revaldinho/cpc-cplink/doc/CPCCPLINKFront.jpg

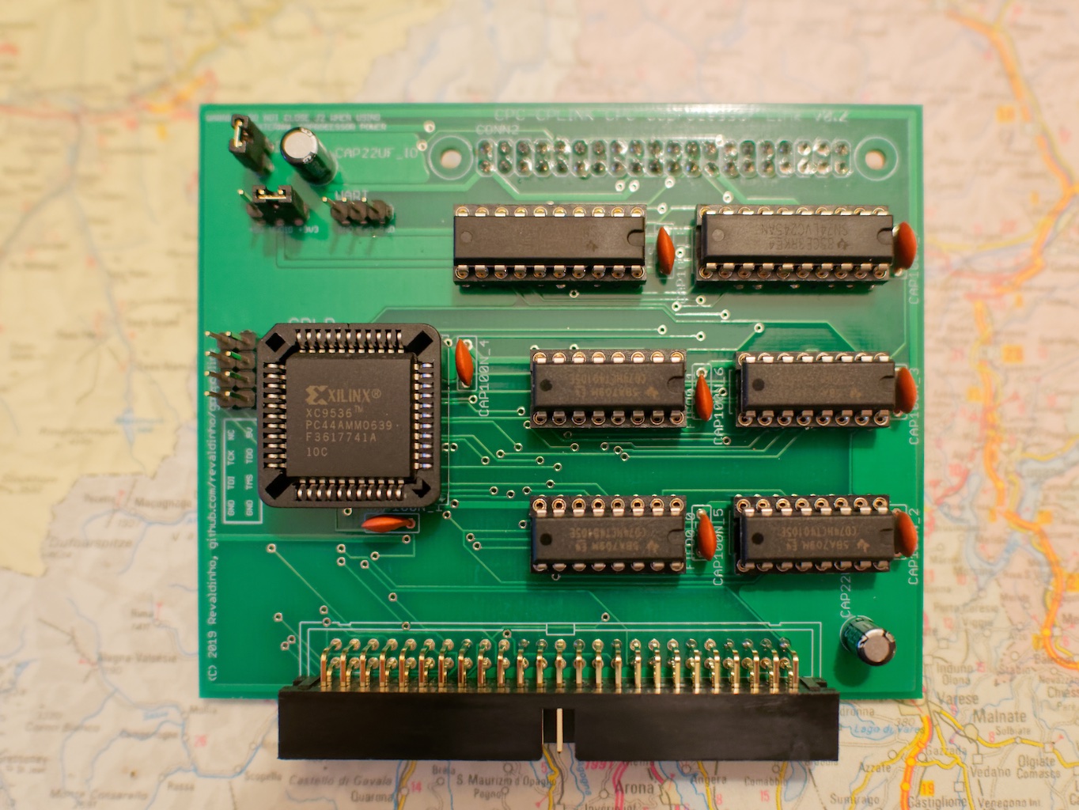
doc/CPCCPLINKFront.jpg
