revaldinho/cpc-cplink/doc/CPCCPLINKinExpBoard.jpg

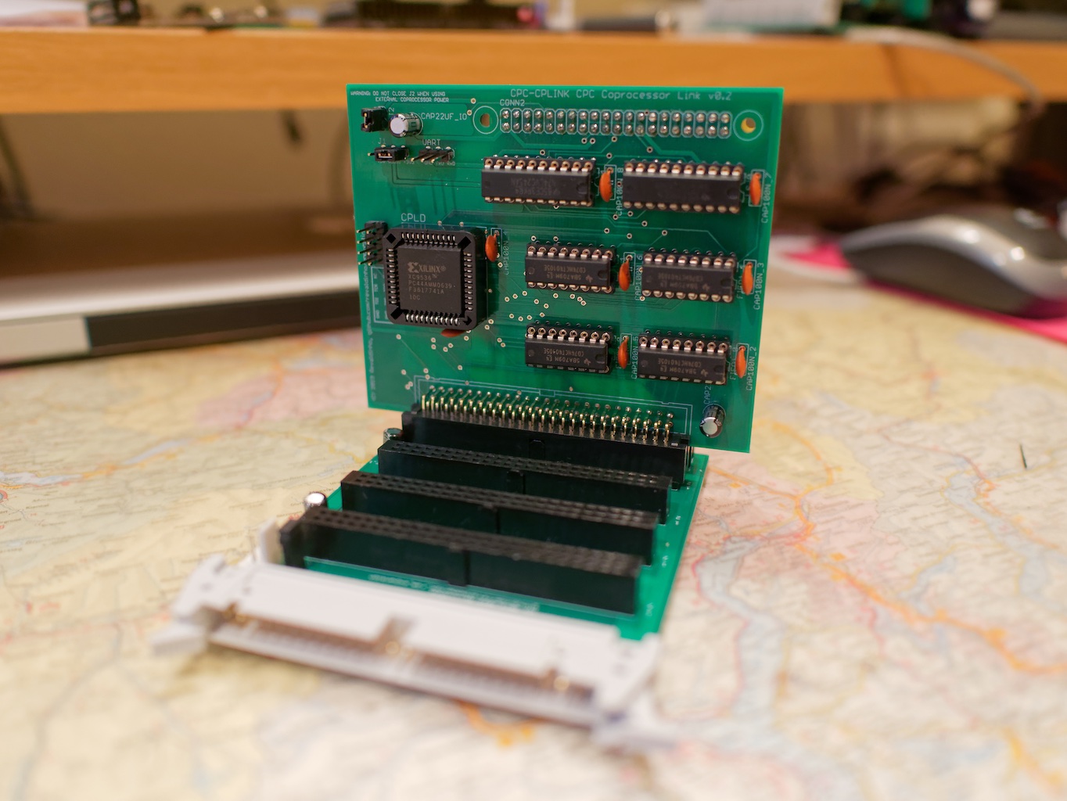
doc/CPCCPLINKinExpBoard.jpg
