revaldinho/cpc-cplink/doc/CPCCPLINKRear.jpg

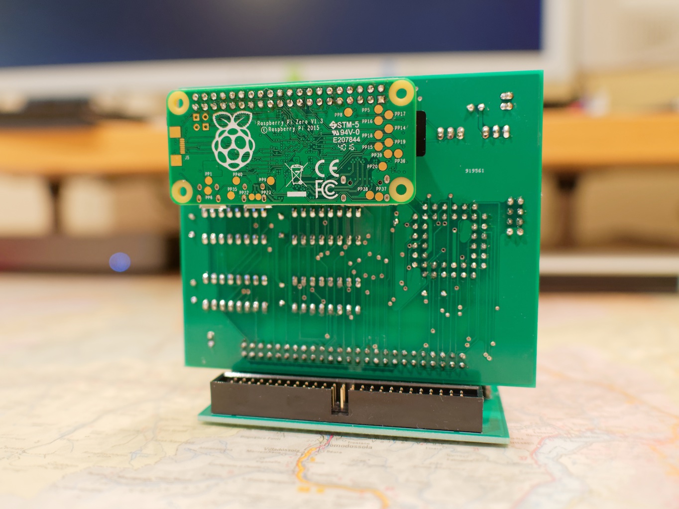
doc/CPCCPLINKRear.jpg
