revaldinho/cpc-cplink/doc/cplink_v0.2.png

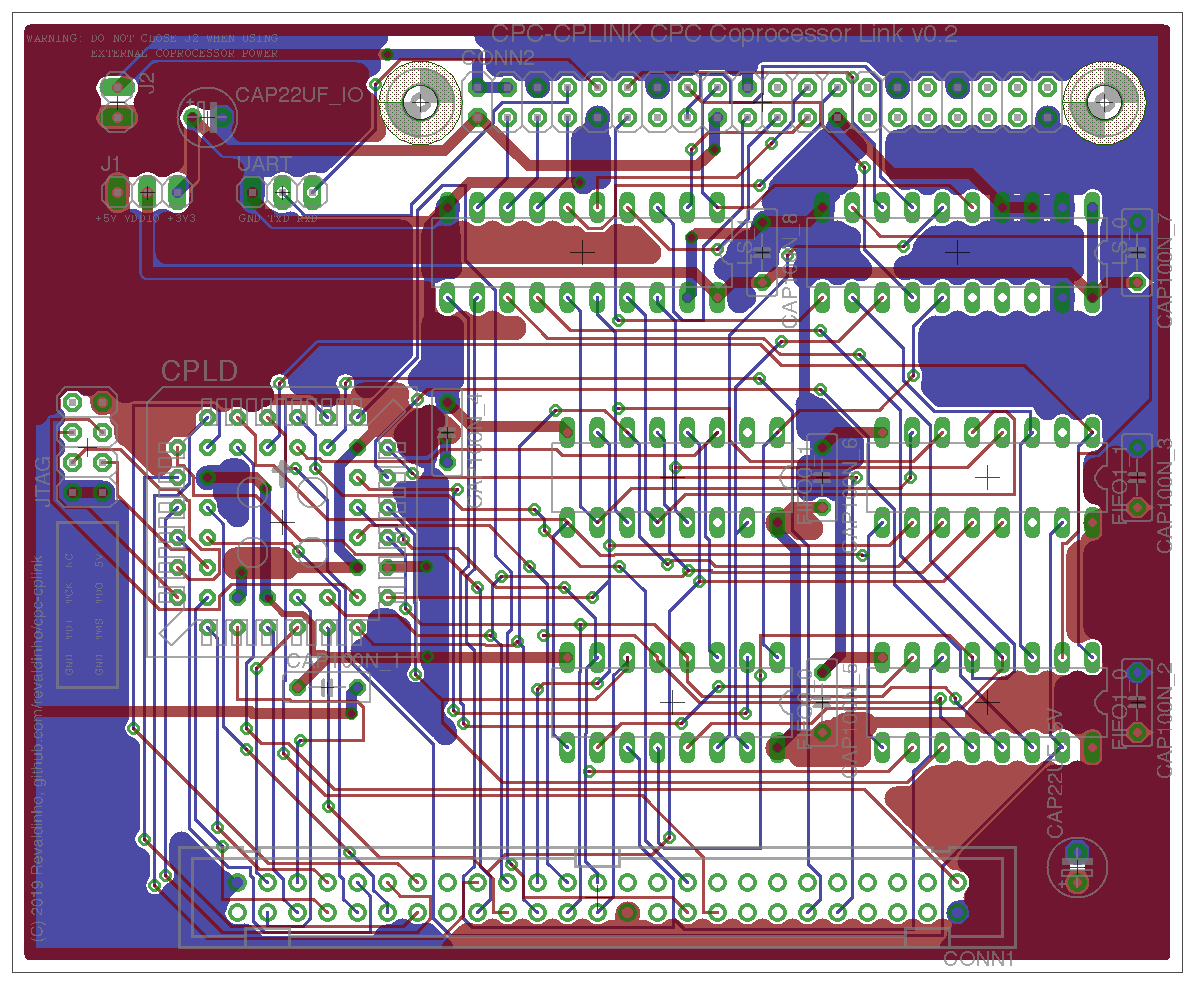
doc/cplink_v0.2.png
