revaldinho/cpc-cplink/doc/cplink_v1.0_placement.png

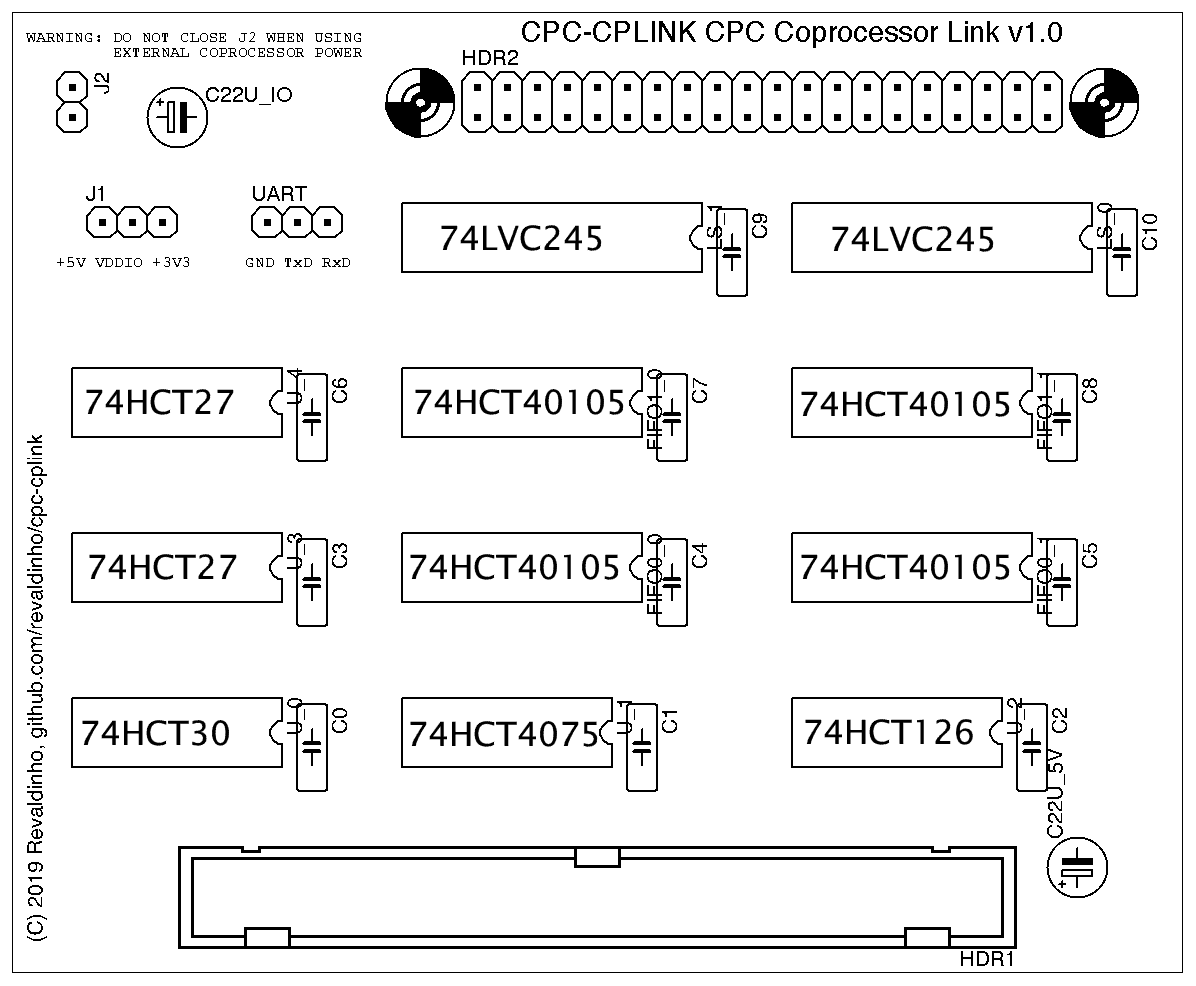
doc/cplink_v1.0_placement.png
