revaldinho/cpc-cplink/doc/ExpBoardAndCards.jpg

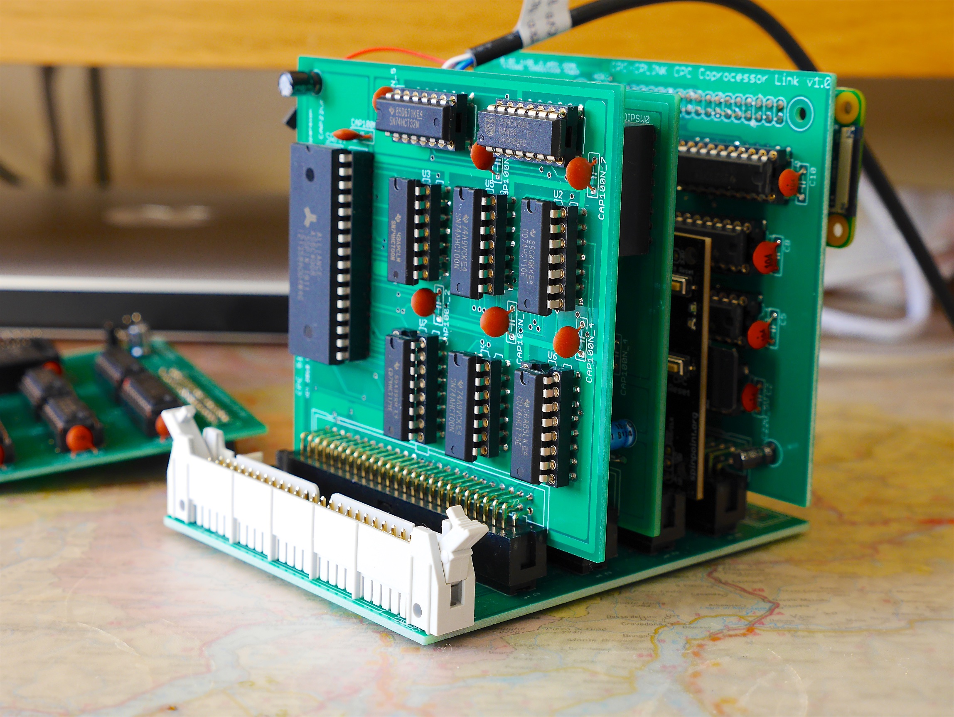
doc/ExpBoardAndCards.jpg
