revaldinho/cpc-cplink/doc/ExpBoardAndCPCCPLINK2.jpg

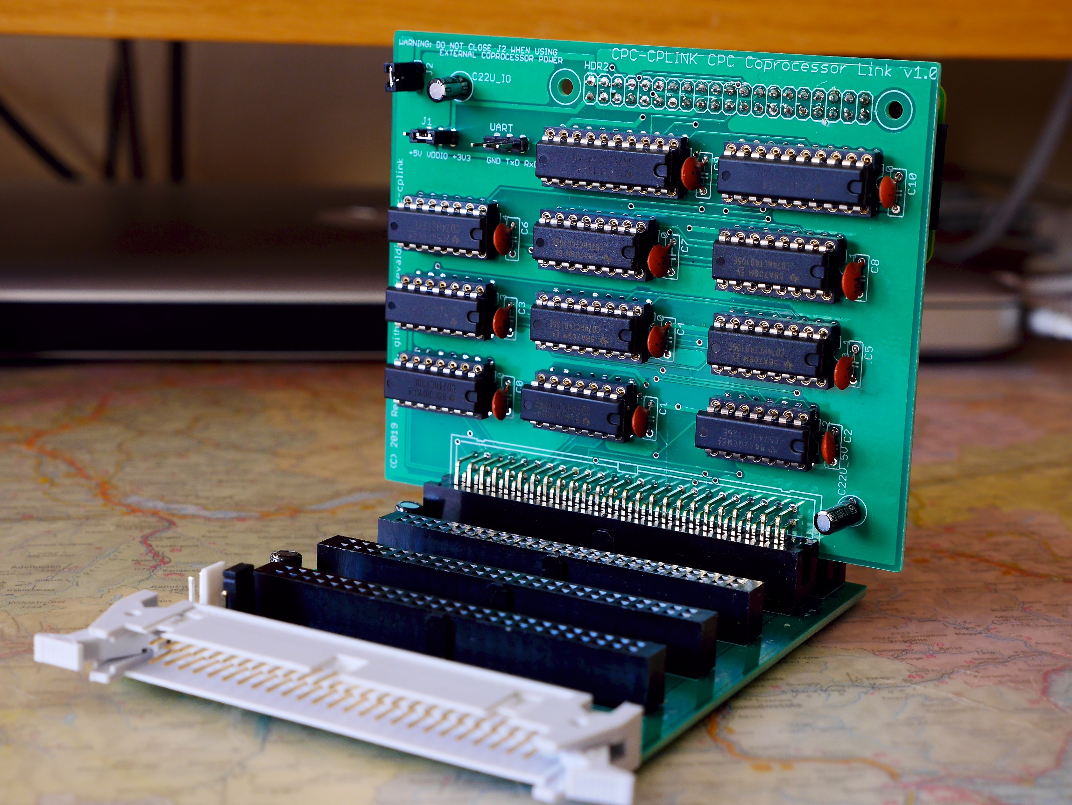
doc/ExpBoardAndCPCCPLINK2.jpg
