revaldinho/cpc-cplink/doc/ExpBoardAndCPCCPLINK.jpg

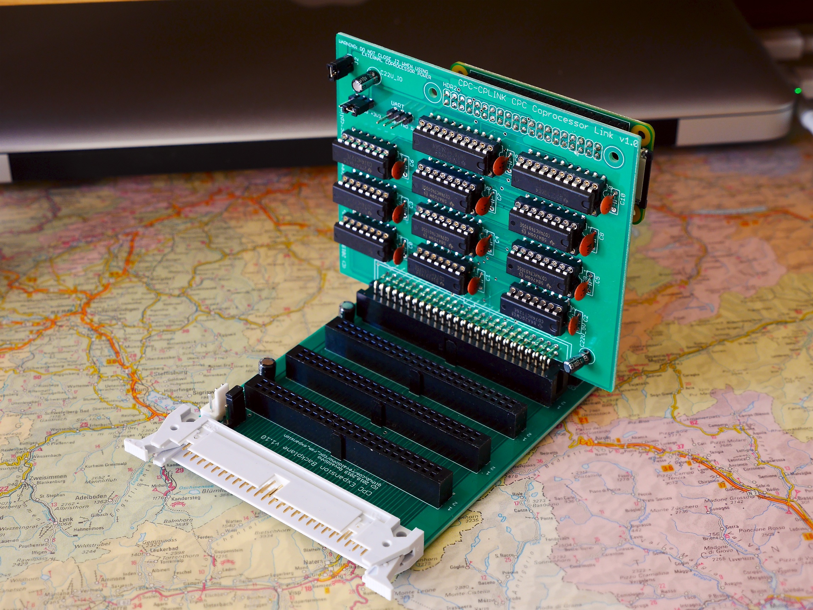
doc/ExpBoardAndCPCCPLINK.jpg
