revaldinho/cpc-cplink/doc/ExpBoardCPCLINK_rear.jpg

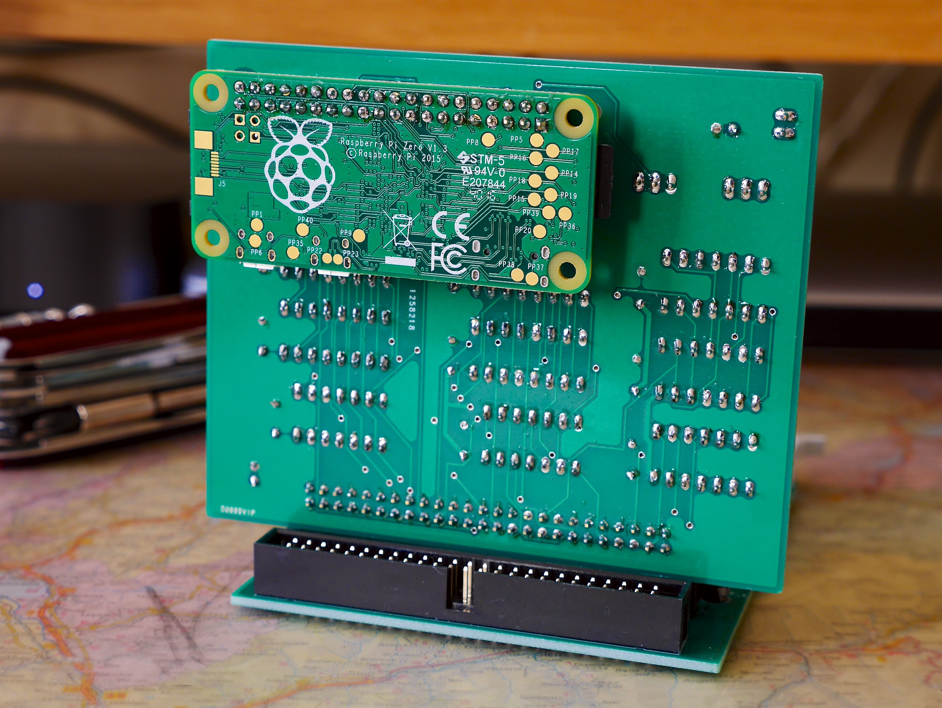
doc/ExpBoardCPCLINK_rear.jpg
