revaldinho/cpc-cplink/doc/HeaderDetail.jpg

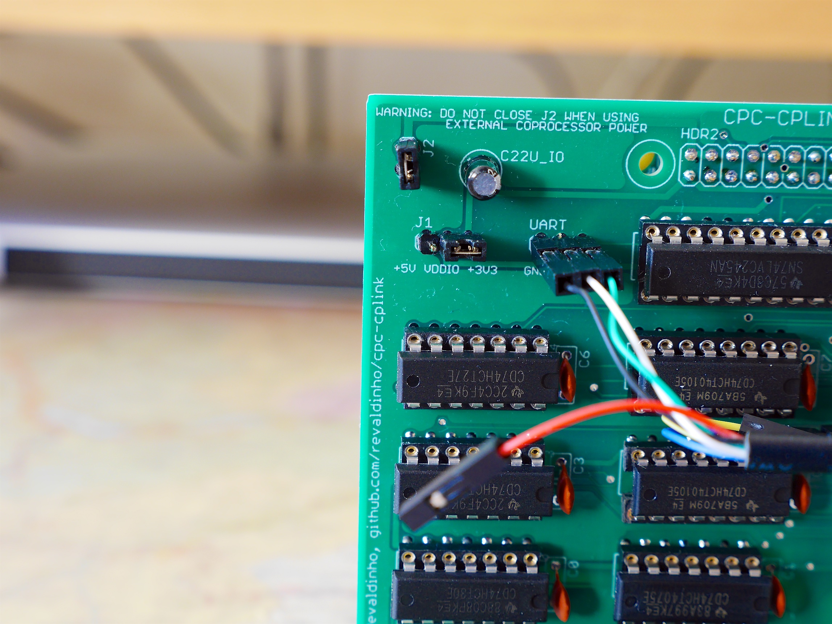
doc/HeaderDetail.jpg
