revaldinho/cpc-cplink/doc/RPi_C_loopback_BCPL.png

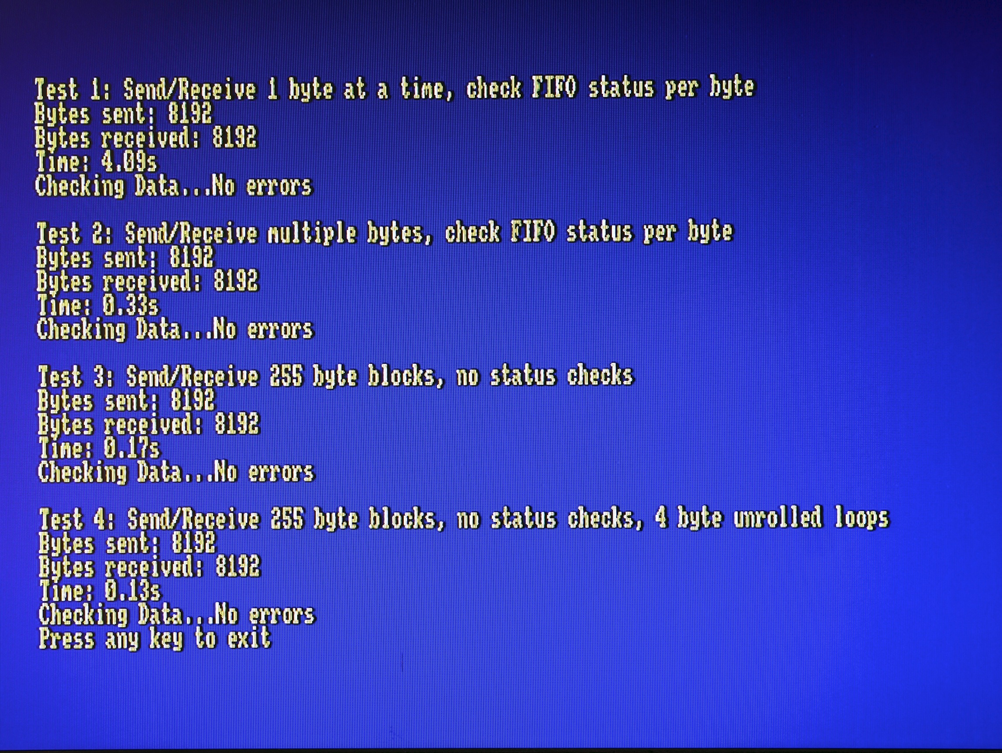
doc/RPi_C_loopback_BCPL.png
