revaldinho/cpc-cplink/doc/RPi_loopback_BCPL.png

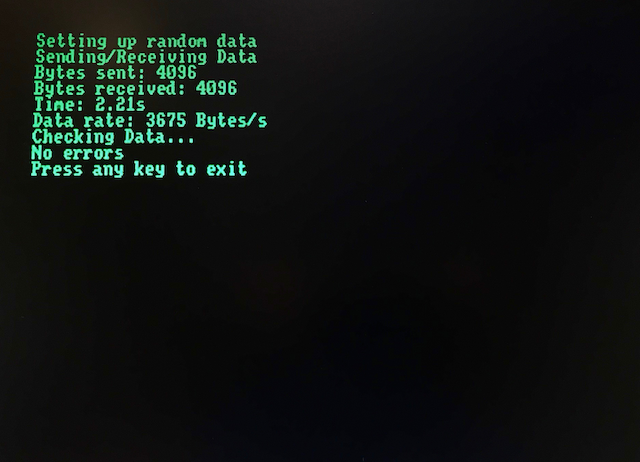
doc/RPi_loopback_BCPL.png
