revaldinho/cpc-cplink/doc/RPi_loopback_scrn.png

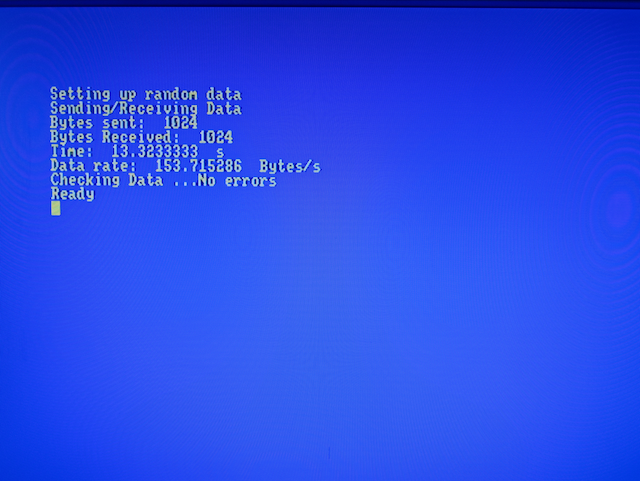
doc/RPi_loopback_scrn.png
