revaldinho/cpc-cplink/doc/V0.2_CPLINK_and_exp.jpg

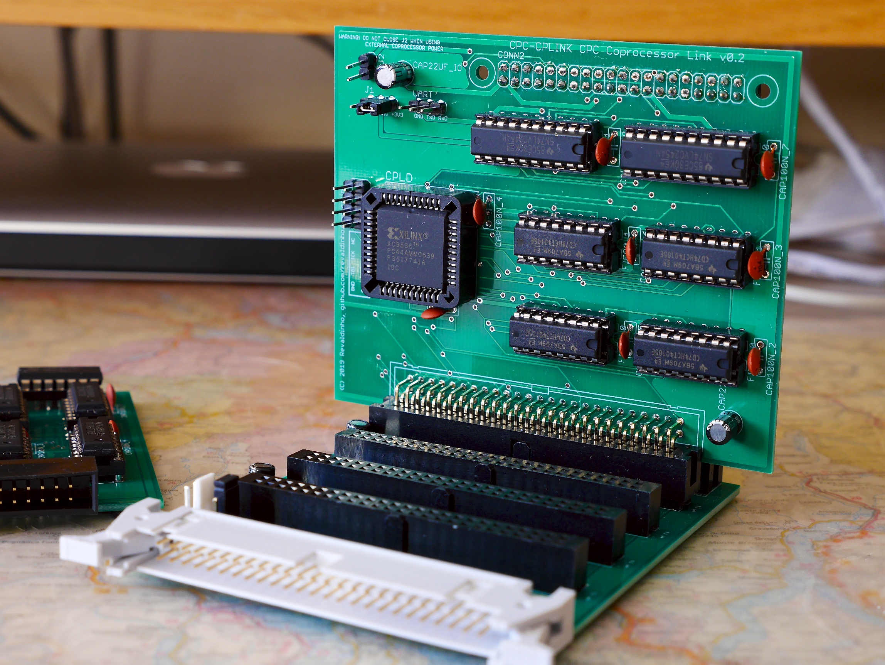
doc/V0.2_CPLINK_and_exp.jpg
