revaldinho/cpc-cplink/doc/V1.0_assembled_rear.jpg

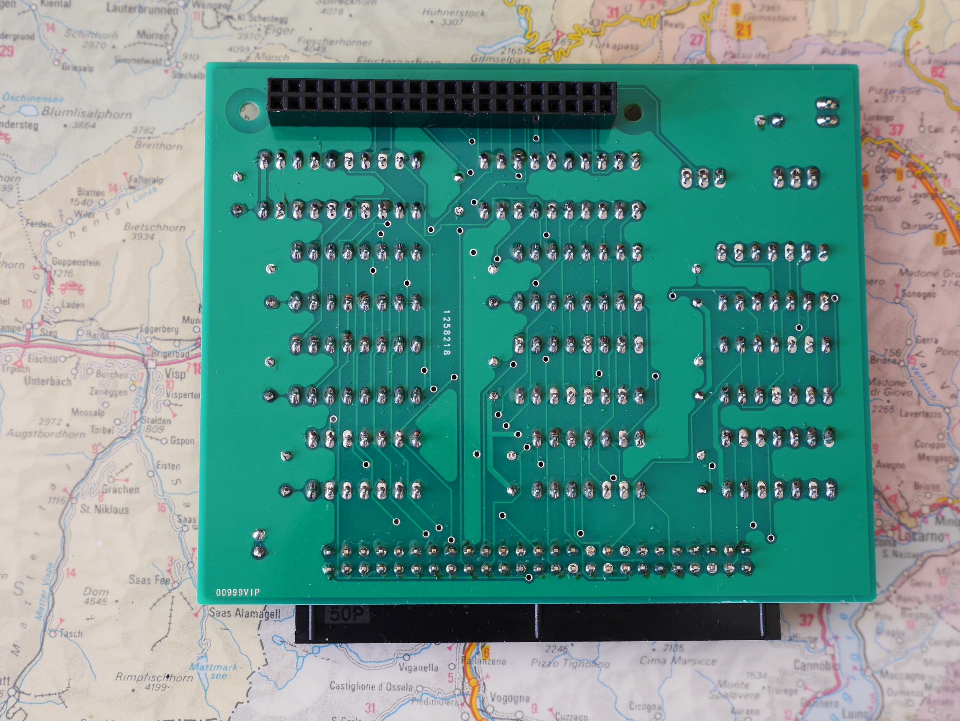
doc/V1.0_assembled_rear.jpg
