revaldinho/cpc-cplink/doc/V1.0_assembled_rear_withPi.jpg

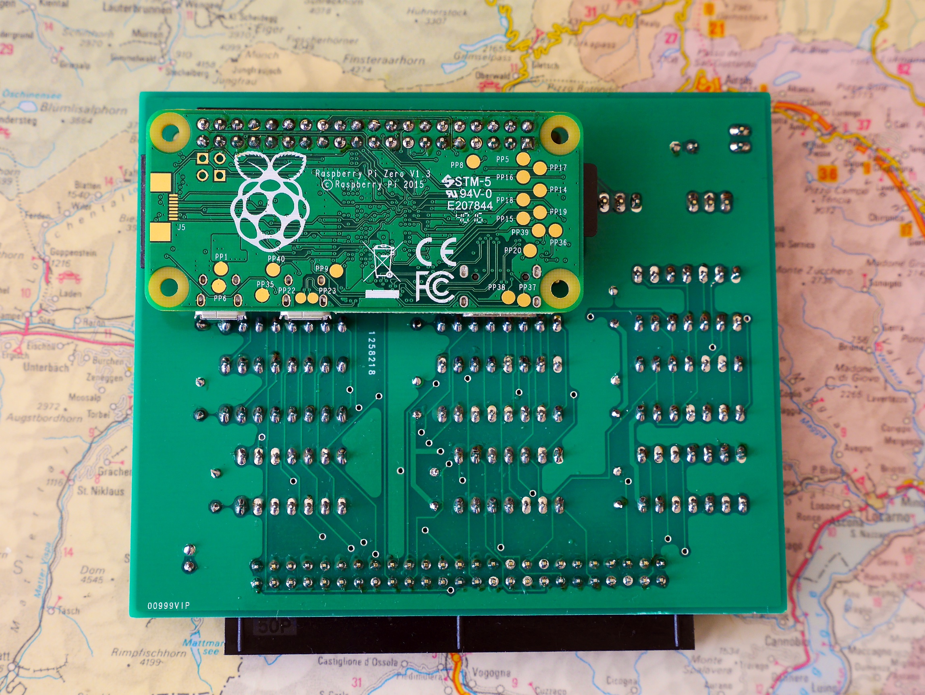
doc/V1.0_assembled_rear_withPi.jpg
