revaldinho/cpc-cplink/(commit log)

2019-06-27 PCB routing/CPLD compiling and fitting
2019-06-28 Revised PCB layout; modified partial host decoding and FIFO control
2019-06-28 Fix LS_0 direction, tie off unused inputs
    [cpc_fifo.v]
2019-06-28 Add more dcoupling, reduce wire sizes, tie off unused 245 inputs
2019-06-29 Rename jumpers to match docs, board rev is now v0.1 preparing for proto run
2019-06-29 PCB wiring fix for host DIR connection
    [cpc_fifo.v]
2019-06-30 revised power autorouting - 2 stage with thinner wires to finish off CPLD connections with poor escape routes
2019-06-30 Add hand-finished proto board
2019-07-02 bump 40W connector left, fully autorouted board for 2nd proto candidate
2019-07-02 Add board images
2019-10-08 Update README.md
    Update docs for working prototype.
2019-10-09 Add board photos
2019-10-11 Update loopback test code and add wiringpi version
2019-10-15 Update netlister paths, add first cut 74 series netlist
2019-10-15 First real attempt at a 74 series PCB
2019-10-16 minor assembler update to fifo.b
2019-10-18 Prepare for shipping PCB
2019-10-18 Add PCB files for 74 Series board.
2019-10-18 Add placement diagram for 74 series board
2019-10-25 Add RaspberryPi C example, add improved CPC BCPL/ASM code
2019-10-26 Update Raspberry pi code - invert SOB signal idle state
    [loopback.py, loopback_wpi.py]
2019-10-29 Fix deque pop bug
    [loopback.py, loopback_wpi.py]
2019-10-30 Update screenshot, tidy up fifo2.b end of assembler routines
2019-10-31 Create library for FIFO functions, merge all FIFO tests into one BCPL file, provide some utilities for converting assembler listings to BCPL INLINE code
2019-11-01 Switch to z80asm for library generation and add Makefile
2019-11-07 Omit assembler source from FIFOLIB.b
2019-11-09 misc C version fixes and implement multi-byte loop and test
    [fifolib.h, main.c]
2019-11-11 Temporarily add conditional compilation for PI1 GPIO numbering - need to rework these examples to use wiringPi numbers
2019-11-20 Update command.c
    Fixed shutdown command which would not work when running MCP as a service
    [command.c]
2019-11-21 Update command.c (#2)
    * Update command.c
    fix shutdown code not merged correctly
    * Update command.c
    Weird merge artifact in reset now fixed
    [command.c]
2019-12-06 refactor raspberry pi loopback test to use external library file
2019-12-06 Add options to Makefile to allow compilation on system without wiringPi
2020-01-06 Add WIRINGPI define to makefile for loopback test
2020-10-28 Reduce polygon wire width to create fenestrations for power
2020-10-28 Reduce polygon wire width to create fenestrations for power, update version number
2022-03-04 Cut down commands for RAM RSX; update help for ROM
2022-03-14 Add first cut (untested) of BBC BASIC loopback program
2022-03-24 Remove WAITS and reorder code in BBC code, fix missing semi-colon
    [loopback.bas, vdu.bas]
